Murek-PK/servo_weather_station/IMG_6163.jpeg

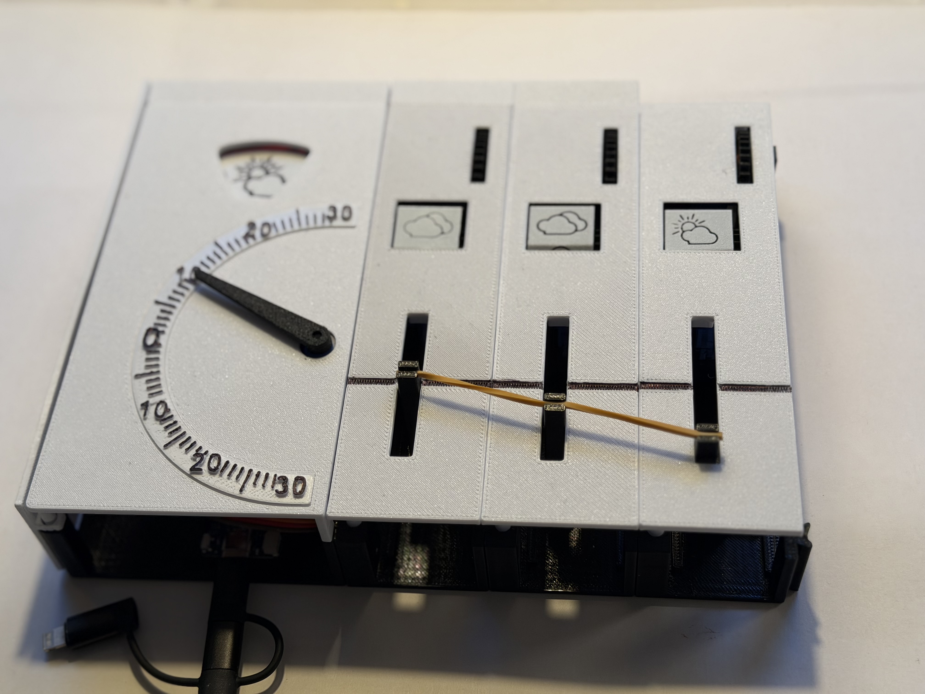
IMG_6163.jpeg
