Murek-PK/servo_weather_station/servo_weather_station_scheme.pdf

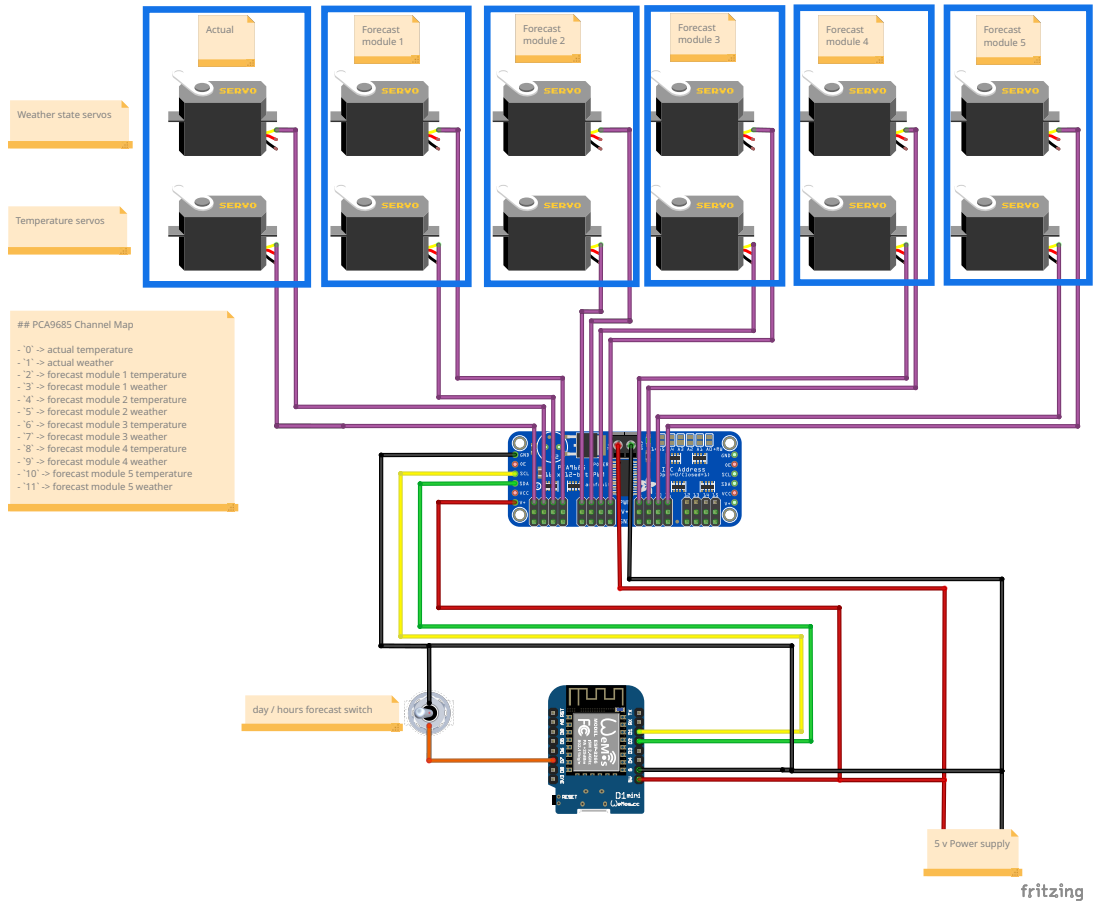
[picture p2: page 1]
Temperature servos; Actual; Forecast; module 1; Forecast module 2; Forecast module 3; Forecast module 4; Forecast module 5; 5 v Power supply

Weather state servos

## PCA9685 Channel Map
- `0` -> actual temperature
- `1` -> actual weather
- `2` -> forecast module 1 temperature
- `3` -> forecast module 1 weather
- `4` -> forecast module 2 temperature
- `5` -> forecast module 2 weather
- `6` -> forecast module 3 temperature
- `7` -> forecast module 3 weather
- `8` -> forecast module 4 temperature
- `9` -> forecast module 4 weather
- `10` -> forecast module 5 temperature
- `11` -> forecast module 5 weather

day / hours forecast switch
